olam-source/speedx-Shh/ESP-NOW prop/docs/wiring-guide.html

# SpeedX Wearable — Wiring & Assembly Guide

Per-athlete armband node · LOLIN D32 (ESP32) · 3.3 V logic · generated from the firmware in include/athlete_sensors.h

Heart-rate sensor: the firmware drives a MAX30102 optical PPG module at I²C address 0x57 (SparkFun MAX3010x library, IR LED for beat detection). The common purple GY-MAX30102 / SparkFun breakouts all work. Mount the optical window flat against the skin and keep the strap snug — contact quality matters more than any firmware tweak.

## 1. Quick facts

Item | Value
Compute board | LOLIN D32 (ESP32, onboard LiPo charger + battery sense)
Logic level | 3.3 V — never feed 5 V into an ESP32 GPIO
I²C bus | shared by HR + IMU; SDA GPIO21, SCL GPIO22, ~100 kHz
GPS link | UART2, 9600 baud (NEO-6M/M8N default)
Common ground | Mandatory — every module's GND ties to the ESP32 GND

## 2. Power & safety

- Battery: a single 18650 or 1S LiPo plugs into the LOLIN D32's JST battery connector. The board charges it over USB and regulates 3.3 V for everything else. Observe polarity — reversed LiPo can vent or catch fire.
- Sensor power: run MAX30102, MPU-6050, and the GPS from the board's 3V3 pin and GND. The NEO-6M also accepts 5 V (use the board VBUS/5V/USB pin) if its module needs it — check your breakout's silkscreen; many NEO-6M boards have an onboard regulator and prefer 3.3–5 V.
- Battery sense: the LOLIN D32 already wires the cell to GPIO35 through an onboard 100k/100k divider (BATTERY_DIVIDER 2.0). No external parts. On a plain ESP32 DevKit you must add that divider yourself.
- Current: the GPS draws the most (~25–35 mA with the antenna searching). The ESP32's 3.3 V regulator handles it, but don't also hang high-draw loads off the same rail.

## 3. Master pinout

ESP32 pin | Connects to | Signal | Notes
GPIO21 | MAX30102 SDA · MPU-6050 SDA | I²C SDA | shared bus
GPIO22 | MAX30102 SCL · MPU-6050 SCL | I²C SCL | shared bus
GPIO16 (RX2) | GPS TX | UART2 RX | data in from GPS
GPIO17 (TX2) | GPS RX | UART2 TX | RX↔TX cross over
GPIO35 | battery divider (onboard) | ADC battery | LOLIN D32 only
3V3 | VCC of HR, IMU (and GPS if 3.3 V) | power | regulated 3.3 V
5V / VBUS | GPS VCC (if it needs 5 V) | power | USB-derived
GND | GND of every module | ground | common return

## 4. Connection diagram

## 5. Module-by-module

### MAX30102 — optical heart rate (I²C 0x57)

Module | ESP32
SDA | GPIO21
SCL | GPIO22
VCC / VIN | 3V3
GND | GND

Mount the optical window against the skin (the enclosure's sensor cut-out). Shield it from ambient light; a snug strap improves the signal far more than firmware tuning.

### MPU-6050 — 6-axis IMU (I²C 0x68)

Module | ESP32
SDA | GPIO21
SCL | GPIO22
VCC | 3V3
GND | GND

Shares the I²C bus with the HR sensor — wire both SDA together and both SCL together. The addresses (0x57 vs 0x68) don't collide. Orient the board flat/consistent so cadence detection is stable.

### NEO-6M — GPS (UART2, 9600 baud)

GPS pin | ESP32 | Note
TX | GPIO16 (RX2) | cross: GPS TX → ESP RX
RX | GPIO17 (TX2) | cross: GPS RX ← ESP TX
VCC | 3V3 or 5V | per your module's regulator
GND | GND

RX/TX always cross. The ceramic patch antenna must face the sky (out the lid window), not the arm. First fix outdoors can take 30–90 s.

### Battery

Plug the 18650/LiPo into the LOLIN D32 JST connector (mind polarity). Charging and 3.3 V regulation are automatic over USB. Voltage is sensed on GPIO35 through the onboard divider.

## 6. Assembly order

1. Bench-test first. Flash the simulated build (pio run -e athlete1 -t upload) on a bare board — confirm it joins the mesh before adding sensors.
2. Solder the I²C pair (HR + IMU): SDA→21, SCL→22, both VCC→3V3, both GND→GND.
3. Power on, open the serial monitor. The firmware logs MAX30102 optical HR ready and the IMU init. If a device is missing, recheck SDA/SCL and 3.3 V.
4. Wire the GPS (remember RX↔TX cross). Take it outside; watch for a fix in the logs.
5. Plug in the battery last. Verify the battery % reads sanely on the dashboard.
6. Fit everything into the printed enclosure (speedx_armband.scad): HR window to skin, GPS antenna to the lid window, screw the lid.

## 7. Flash quick-reference

Goal | Command
Bench test (no sensors) | pio run -e athlete1 -t upload
Real hardware wearable | pio run -e athlete1_hw -t upload
Coach hub (USB to laptop) | pio run -e coach_hub -t upload
Serial monitor | pio device monitor -b 115200

Give each athlete a unique ATHLETE_NODE_ID (any hex 1–FFFD; FFFE/FFFF reserved) by copying the [env:athlete1_hw] block in platformio.ini.

## 8. Troubleshooting

Symptom | Likely cause | Fix
No HR / sensor not found | swapped SDA/SCL, no 3.3 V, dead/clone module | confirm a MAX30102 (0x57) on the bus; re-check I²C wiring & power
HR reads but noisy | loose strap, ambient light, hard effort | tighten strap; shroud the window
No GPS fix | RX/TX not crossed, antenna facing arm, indoors | swap 16/17; antenna to sky; go outside
IMU dead | address clash / bad solder | verify 0x68 on the bus; reflow joints
Battery % wrong | not a LOLIN D32 (no onboard divider) | add 100k/100k divider to an ADC pin; set -DPIN_BATTERY_ADC
Won't join mesh | different ESP-NOW channel/key | all nodes share channel + ESPNOW_ENCRYPT key

SpeedX wearable wiring guide · pins/addresses sourced from include/athlete_sensors.h. Print: File → Print (or ⌘P) → Save as PDF. Verify against your exact breakout's silkscreen before powering on.
