olam-source/speedx-Shh/ESP-NOW prop/src/athlete_wearable/main.cpp

#include <Arduino.h>
#include <WiFi.h>
#include <esp_now.h>
#include <Preferences.h>
#include "espnow_config.h"
#include "espnow_utils.h"
#include "peer_manager.h"
#include "athlete_sensors.h"
#include "ota_portal.h"

// Build-flag values are only the *defaults*. The live athlete id/team are stored
// in NVS and can be set over USB (`id <n>` / `team <n>`), so one identical binary
// flashes to every wearable — no per-athlete compile needed.
#ifndef ATHLETE_NODE_ID
#define ATHLETE_NODE_ID 11
#endif

#ifndef ATHLETE_TEAM_ID
#define ATHLETE_TEAM_ID 1
#endif

PeerManager peer_manager;
AthleteSensors sensors;          // simulated, or real hardware with -DUSE_REAL_SENSORS
Preferences prefs;               // NVS store for the runtime athlete id/team
GossipCache gossip_cache;
uint8_t sequence_number = 0;
uint16_t sample_id = 0;
uint32_t last_metric_time = 0;
uint32_t last_discovery_time = 0;
uint32_t last_peer_check = 0;
uint8_t last_peer_count = 0;

// Live identity, loaded from NVS at boot (falls back to the build-flag defaults).
node_id_t g_athlete_id = ATHLETE_NODE_ID;   // 16-bit; coach app shows it as hex
uint8_t g_team_id = ATHLETE_TEAM_ID;

// Session state, driven by coach commands relayed through the mesh.
bool session_paused = false;     // STOP_SESSION halts metric sampling

// OTA update mode (SoftAP firmware upload). While active the node leaves the mesh.
OtaPortal ota;
bool ota_mode = false;

// USB provisioning console.
String serial_line;


void onDataSent(const uint8_t* mac_addr, esp_now_send_status_t status) {
    if (status != ESP_NOW_SEND_SUCCESS) {
        Serial.printf("{\"t\":\"tx\",\"to\":\"%s\",\"ok\":false}\n",
                      ESPNowUtils::macToString(mac_addr).c_str());
    }
}

AthleteMetricsPayload readAthleteMetrics() {
    AthleteMetricsPayload metrics{};
    metrics.athlete_id = g_athlete_id;
    metrics.team_id = g_team_id;
    metrics.sample_id = sample_id++;
    metrics.uptime_ms = millis();

    // The sensor layer fills HR, pace, splits, distance, cadence, battery, etc.
    // (real hardware with -DUSE_REAL_SENSORS, otherwise simulated values).
    sensors.fillMetrics(metrics);
    return metrics;
}

void sendDiscoveryPing() {
    ESPNowMessage ping = ESPNowUtils::createPingMessage(g_athlete_id, COACH_HUB_NODE_ID, sequence_number++);
    ping.flags |= ESPNOW_FLAG_GOSSIP;
    ESPNowUtils::broadcastMessage(ping);
    Serial.println("Discovery ping broadcast for coach hub");
}

bool gossipMessage(ESPNowMessage msg) {
    if (msg.ttl == 0) {
        return false;
    }

    msg.ttl--;
    msg.hop_count++;
    msg.flags |= ESPNOW_FLAG_GOSSIP;

    PeerInfo* hub = peer_manager.getPeerById(COACH_HUB_NODE_ID);
    if (hub) {
        return ESPNowUtils::sendMessage(hub->mac, msg);
    }

    uint8_t active_count = peer_manager.getActivePeerCount();
    if (active_count == 0) {
        return ESPNowUtils::broadcastMessage(msg);
    }

    bool sent = false;
    uint8_t attempts = min<uint8_t>(GOSSIP_FANOUT, active_count);
    uint8_t start = random(0, active_count);
    for (uint8_t i = 0; i < attempts; i++) {
        PeerInfo* peer = peer_manager.getActivePeerByIndex((start + i) % active_count);
        if (peer && peer->peer_id != msg.sender_id) {
            sent |= ESPNowUtils::sendMessage(peer->mac, msg);
        }
    }

    if (!sent) {
        sent = ESPNowUtils::broadcastMessage(msg);
    }
    return sent;
}

void sendOwnMetrics() {
    AthleteMetricsPayload metrics = readAthleteMetrics();
    ESPNowMessage msg = ESPNowUtils::createAthleteMetricsMessage(g_athlete_id, sequence_number++, metrics);
    gossip_cache.remember(msg);
    bool queued = gossipMessage(msg);

    Serial.printf("Metric sample %u HR=%u pace=%u split=%u dist=%um gossip=%s\n",
                  metrics.sample_id,
                  metrics.heart_rate_bpm,
                  metrics.pace_sec_per_mile,
                  metrics.current_split_sec,
                  metrics.distance_m,
                  queued ? "queued" : "failed");
}

void handleAthleteMetrics(const uint8_t* mac, const ESPNowMessage& msg) {
    AthleteMetricsPayload metrics{};
    if (!ESPNowUtils::readAthleteMetrics(msg, metrics)) {
        Serial.println("Bad athlete metrics payload");
        return;
    }

    metrics.signal_percent = ESPNowUtils::rssiToPercentage(static_cast<int8_t>(msg.rssi));
    Serial.printf("Gossip RX athlete=%u sample=%u HR=%u pace=%u hops=%u ttl=%u\n",
                  metrics.athlete_id,
                  metrics.sample_id,
                  metrics.heart_rate_bpm,
                  metrics.pace_sec_per_mile,
                  msg.hop_count,
                  msg.ttl);

    if (msg.flags & ESPNOW_FLAG_ACK_REQUESTED) {
        ESPNowMessage ack = ESPNowUtils::createAckMessage(g_athlete_id, msg.sender_id, msg.sequence);
        ESPNowUtils::sendMessage(mac, ack);
    }

    // De-dup cache already prevents loops; forward every unique frame so no
    // athlete's metrics are dropped at relay nodes in multi-athlete sessions.
    gossipMessage(msg);
}

void handleCoachCommand(const ESPNowMessage& msg) {
    CoachCommandPayload cmd{};
    if (!ESPNowUtils::readCoachCommand(msg, cmd)) {
        return;
    }

    bool for_me = cmd.target_athlete == COACH_TARGET_ALL || cmd.target_athlete == g_athlete_id;
    if (for_me) {
        switch (static_cast<CoachCommand>(cmd.command)) {
            case CoachCommand::START_SESSION:
                sensors.onSessionStart();
                session_paused = false;
                Serial.println("Coach: START session");
                break;
            case CoachCommand::STOP_SESSION:
                session_paused = true;
                Serial.println("Coach: STOP session");
                break;
            case CoachCommand::MARK_LAP:
                sensors.markLap();
                Serial.printf("Coach: MARK lap %u\n", cmd.param);
                break;
            case CoachCommand::RESET_BEST:
                sensors.resetBest();
                Serial.println("Coach: RESET best split");
                break;
            case CoachCommand::IDENTIFY:
                Serial.printf("Coach: IDENTIFY athlete %u\n", g_athlete_id);
                break;
            default:
                break;
        }
    }

    // Keep flooding the command outward so every wearable in the mesh gets it.
    gossipMessage(msg);
}

void handleIncomingMessage(const uint8_t* mac, const ESPNowMessage& msg) {
    ESPNowUtils::ensurePeer(mac);
    peer_manager.registerPeer(mac, msg.sender_id);
    peer_manager.updatePeerActivity(mac, static_cast<int8_t>(msg.rssi), msg.sequence);

    if (msg.sender_id == g_athlete_id || gossip_cache.contains(msg)) return;
    gossip_cache.remember(msg);

    switch (msg.type) {
        case MessageType::ATHLETE_METRICS:
            handleAthleteMetrics(mac, msg);
            break;
        case MessageType::COACH_COMMAND:
            handleCoachCommand(msg);
            break;
        case MessageType::PONG:
        case MessageType::ACK:
            Serial.printf("Hub/peer response from Node %u for seq %u\n", msg.sender_id, msg.sequence);
            break;
        case MessageType::MESH_BEACON:
        case MessageType::PING:
            break;
        default:
            if (msg.flags & ESPNOW_FLAG_GOSSIP) {
                gossipMessage(msg);
            }
            break;
    }
}

#if defined(ESP_ARDUINO_VERSION_MAJOR) && ESP_ARDUINO_VERSION_MAJOR >= 3
void onDataReceived(const esp_now_recv_info_t* recv_info, const uint8_t* data, int data_len) {
    const uint8_t* mac = recv_info->src_addr;
#else
void onDataReceived(const uint8_t* mac, const uint8_t* data, int data_len) {
#endif
    ESPNowMessage msg{};
    if (!ESPNowUtils::parseMessage(data, data_len, msg)) {
        Serial.printf("Invalid frame: %d bytes\n", data_len);
        return;
    }

    handleIncomingMessage(mac, msg);
}

// ===== USB provisioning console =================================================
// Lets you assign each wearable's identity at runtime, so one binary serves all:
//   id <hex 1-FFFD>   set this athlete's node id (saved to NVS, then reboots)
//   team <0-255> set this athlete's team
//   info         print current id/team/MAC
//   reset-id     clear stored id/team (revert to build-flag defaults)
void applyAndRestart(const char* what) {
    prefs.end();
    Serial.printf("Saved %s. Restarting...\n", what);
    delay(200);
    ESP.restart();
}

bool parseUnsignedArg(const String& text, uint8_t base, uint32_t minValue, uint32_t maxValue, uint32_t& out) {
    if (text.length() == 0) {
        return false;
    }
    char* end = nullptr;
    unsigned long value = strtoul(text.c_str(), &end, base);
    if (end == text.c_str() || *end != '\0') {
        return false;
    }
    if (value < minValue || value > maxValue) {
        return false;
    }
    out = static_cast<uint32_t>(value);
    return true;
}

void handleSerialCommand(String line) {
    line.trim();
    if (line.length() == 0) return;

    int sp = line.indexOf(' ');
    String verb = (sp < 0) ? line : line.substring(0, sp);
    String arg = (sp < 0) ? String("") : line.substring(sp + 1);
    verb.toLowerCase();
    arg.trim();

    if (verb == "id") {
        // IDs are hex (e.g. "1a2b" or "0x1A2B"). base 16 accepts an optional 0x.
        uint32_t v = 0;
        if (!parseUnsignedArg(arg, 16, 1, NODE_ID_MAX, v)) {
            Serial.println("id must be hex 1-FFFD (FFFE=hub, FFFF=broadcast are reserved)");
            return;
        }
        prefs.putUShort("nid", static_cast<node_id_t>(v));
        applyAndRestart("athlete id");
    } else if (verb == "team") {
        uint32_t v = 0;
        if (!parseUnsignedArg(arg, 10, 0, 255, v)) {
            Serial.println("team must be 0-255");
            return;
        }
        prefs.putUChar("team", static_cast<uint8_t>(v));
        applyAndRestart("team");
    } else if (verb == "info") {
        uint8_t mac[6];
        ESPNowUtils::getDeviceMac(mac);
        Serial.printf("id=0x%04X (%u) team=%u mac=%s uptime=%lus\n",
                      g_athlete_id, g_athlete_id, g_team_id,
                      ESPNowUtils::macToString(mac).c_str(),
                      static_cast<unsigned long>(millis() / 1000));
    } else if (verb == "reset-id") {
        prefs.remove("nid");
        prefs.remove("team");
        applyAndRestart("defaults");
    } else if (verb == "ota") {
        ota.begin(String("SpeedX-OTA-") + g_athlete_id);
        ota_mode = true;
#if defined(USE_BLE_HR)
    } else if (verb == "ble") {
        Serial.println(sensors.bleStatus());
#endif
    } else if (verb == "help") {
        Serial.println("commands: id <hex 1-FFFD> | team <0-255> | info | ota | reset-id"
#if defined(USE_BLE_HR)
                       " | ble"
#endif
                       " | help");
    } else {
        Serial.printf("unknown command '%s' (try help)\n", verb.c_str());
    }
}

void pollSerialConsole() {
    while (Serial.available() > 0) {
        char c = static_cast<char>(Serial.read());
        if (c == '\n' || c == '\r') {
            if (serial_line.length() > 0) {
                handleSerialCommand(serial_line);
                serial_line = "";
            }
        } else if (serial_line.length() < 48) {
            serial_line += c;
        }
    }
}

void setupWiFi() {
    if (!ESPNowUtils::initWiFi("Athlete_Wearable")) {
        while (true) delay(1000);
    }

    uint8_t mac[6];
    ESPNowUtils::getDeviceMac(mac);
    Serial.print("Wearable MAC: ");
    Serial.println(ESPNowUtils::macToString(mac));
}

void setupESPNow() {
    if (!ESPNowUtils::initESPNow()) {
        while (true) delay(1000);
    }

    esp_now_register_send_cb(onDataSent);
    esp_now_register_recv_cb(onDataReceived);
    ESPNowUtils::addBroadcastPeer();
}

void setup() {
    Serial.begin(115200);
    delay(1000);

    // Load the runtime identity (NVS), falling back to the build-flag defaults.
    prefs.begin("speedx", false);
    g_athlete_id = prefs.getUShort("nid", ATHLETE_NODE_ID);   // 16-bit id (key "nid")
    g_team_id = prefs.getUChar("team", ATHLETE_TEAM_ID);
    randomSeed(static_cast<uint32_t>(micros()) ^ g_athlete_id);

    Serial.println("\n\n=== Athlete Wearable Gossip Node ===");
    Serial.printf("{\"t\":\"boot\",\"role\":\"wearable\",\"node\":%u,\"team\":%u,\"fw\":\"%s\"}\n",
                  g_athlete_id, g_team_id, SPEEDX_FW_VERSION);
    Serial.printf("Coach Hub: 0x%04X | Channel: %u\n", COACH_HUB_NODE_ID, ESPNOW_CHANNEL);
    Serial.println("USB console: id <hex 1-FFFD> | team <0-255> | info | ota | reset-id | help");

    setupWiFi();
    setupESPNow();

    if (!sensors.begin()) {
        Serial.println("Sensor init incomplete - continuing with available data");
    }

#if defined(USE_BLE_HR)
    sensors.beginBle();
    Serial.println(sensors.bleStatus());
    Serial.println("  Pair once in Garmin/Coros/Apple Watch sensor settings (device name: SpeedX)");
#endif

    sendDiscoveryPing();
    last_discovery_time = millis();
}

void loop() {
    uint32_t now = millis();

    pollSerialConsole();   // accept id/team provisioning over USB

    if (ota_mode) {        // OTA portal owns the radio; mesh is suspended until reboot
        ota.handle();
        delay(2);
        return;
    }

    sensors.update();      // keep streaming sensors (HR beats, GPS bytes, IMU) fresh

    if (!session_paused && now - last_metric_time >= ATHLETE_METRIC_INTERVAL_MS) {
        sendOwnMetrics();
        last_metric_time = now;
    }

    if (now - last_discovery_time >= ESPNOW_DISCOVERY_INTERVAL_MS) {
        sendDiscoveryPing();
        last_discovery_time = now;
    }

    if (now - last_peer_check >= 5000) {
        peer_manager.checkPeerTimeout(ESPNOW_DEFAULT_PEER_TIMEOUT_MS);
        uint8_t peers = peer_manager.getActivePeerCount();
        if (peers != last_peer_count) {
            Serial.printf("{\"t\":\"peers\",\"count\":%u}\n", peers);
            last_peer_count = peers;
        }
        last_peer_check = now;
    }

    delay(5);   // tight loop keeps HR beat-detection and GPS UART reads responsive
}
