olam-source/speedx-Shh/(commit log)

2026-06-18 Add ESP-NOW multi-node framework and examples
    Introduce a complete ESP-NOW workspace: PlatformIO project files, VS Code configs, README, and a .gitignore. Adds core headers (espnow_config.h, espnow_utils.h, peer_manager.h) providing message structures, utilities and peer management, plus three example nodes (sender, receiver, mesh) under src/. Includes platformio.ini with three envs and VSCode tasks/launch/extension recommendations. Note: update receiver MAC and serial ports in platformio.ini/source before flashing.
2026-06-18 Add athlete wearable mesh + coach hub and live dashboard
    Completes the SpeedX router-free athlete-tracking system on top of the
    ESP-NOW framework:
    - coach_hub: central USB ESP-NOW adapter (mesh sink) that collects every
    athlete's metrics, streams them to the host as line-delimited JSON,
    beacons for discovery, ACKs frames, and relays coach commands.
    - athlete_wearable: now honors coach commands (start/stop/mark-lap/
    reset-best/identify) relayed through the gossip mesh, with session-
    relative distance/splits.
    - espnow_config/espnow_utils: CoachCommand type + payload, command
    builder/parser, and a JSON metrics printer for the USB stream.
    - dashboard/coach_dashboard.html: zero-install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
    [espnow_config.h, espnow_utils.h, main.cpp]
2026-06-18 Add real sensor support: MAX30102 HR, MPU-6050, GPS, battery
    Make the wearable read real hardware instead of only simulating:
    - include/athlete_sensors.h: AthleteSensors abstraction with two back ends
    selected at build time. Default = simulated metrics (bare ESP32, no
    sensors). -DUSE_REAL_SENSORS = MAX30102 heart rate, MPU-6050 cadence/
    dynamics, u-blox NEO-M8N/6M GPS distance/pace/splits, and battery ADC.
    - athlete_wearable: delegates metric reads to the sensor layer and pumps
    it every loop; coach commands drive session/lap/best hooks.
    - platformio.ini: athlete1_hw env with -DUSE_REAL_SENSORS and lib_deps
    (SparkFun MAX3010x, TinyGPSPlus, Adafruit MPU6050).
    - HARDWARE.md: cheap/sc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
2026-06-19 Fix invalid board id (esp32doit-devkit1 -> esp32doit-devkit-v1)
    The board id never matched a real PlatformIO board, so no environment
    could build. Corrected to the canonical DOIT ESP32 DEVKIT V1 id.
    Verified by building every environment with PlatformIO 6.1.19 +
    espressif32 7.0.1 (Arduino-ESP32 3.x): coach_hub, athlete1 (simulated),
    athlete1_hw (real MAX30102/MPU-6050/GPS libraries), and the three legacy
    demo nodes all compile and link.
2026-06-19 Add multi-page project wiki (docs/) for developers
    A Notion-style, linked knowledge base under ESP-NOW prop/docs/, written for
    developers/engineers and importable into Notion (Markdown import):
    - Home/index with page directory and at-a-glance table
    - 01 Overview, 02 Architecture (with mermaid diagrams), 03 Mesh Protocol,
    04 Firmware & Code Map, 05 Sensors & Metrics, 06 Hardware & Budget,
    07 Build/Flash/Dashboard, 08 Manufacturing & Roadmap
    Cross-linked to the source files and to HARDWARE.md; README now points to it.
2026-06-19 firmware: runtime athlete-ID provisioning (one binary for all wearables)
    Athlete id/team are now stored in NVS and set over USB at runtime, so the
    same binary flashes to every wearable instead of compiling one per athlete.
    Build-flag values become defaults only.
    - USB console: id <1-249> | team <0-255> | info | reset-id | help
    (id/team changes persist to NVS and reboot)
    - replaced compile-time ATHLETE_NODE_ID/TEAM usages with runtime globals
    - verified: athlete1 (sim) and athlete1_hw (real sensors) both build
    - docs: updated "adding athletes" + roadmap statuses
    [main.cpp]
2026-06-19 firmware: AES-256-GCM frame encryption + OTA firmware updates
    Encryption (include/espnow_crypto.h):
    - Authenticated payload encryption (AES-256-GCM via mbedtls) for every
    frame; header stays clear for relay routing but immutable fields are
    bound as GCM AAD. Foreign/forged frames fail the tag check and drop.
    - Wire payload = [12B IV][ciphertext][16B tag]; per-hop re-encryption.
    - Key = SHA-256(passphrase); set -DESPNOW_PSK_PASSPHRASE, default ON,
    disable with -DESPNOW_ENCRYPT=0. Wired into ESPNowUtils send/parse.
    OTA (include/ota_portal.h):
    - `ota` USB command starts a SoftAP + web upload page (Update.h) so a
    wearable can be reflashed wirelessly with no router.
    Verified: coach_hub,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
    [espnow_crypto.h, espnow_utils.h, main.cpp, ota_portal.h]
2026-06-19 Prune over-engineering (ponytail audit): -3 demo nodes + dead code
    - delete node_sender/receiver/mesh demos + their platformio envs and docs
    - delete dead Config struct, SensorDataPayload, printAthleteMetricsCsv,
    createDataMessage/createMeshDataMessage, PeerManager removePeer/updatePeerRssi
    - trim addPeer to (mac, channel) — ESP-NOW per-peer encrypt path unused
    - drop unused MessageType values (DATA/CONFIG/ERROR/MESH_DATA/ATHLETE_EVENT)
    - coach_hub AthleteRecord: drop write-only metrics/hops/rssi/total_samples
    - drop athlete2/3 envs (runtime `id` provisioning replaces them)
    Verified: coach_hub, athlete1, athlete1_hw all build.
    [espnow_config.h, espnow_utils.h, main.cpp, peer_manager.h]
2026-06-21 firmware: fix gossip relay dropping peer metrics in multi-athlete mesh
    The global last_gossip_time gate in handleAthleteMetrics capped relay
    throughput to one forwarded frame per 750 ms regardless of how many
    athletes were transmitting. In a 30-athlete session a relay node would
    drop ~95 % of received peer metrics. The de-dup cache already prevents
    routing loops via sequence+origin tracking, so the rate-limit was both
    incorrect and redundant. Removed the gate and the dead variable.
    [main.cpp]
2026-06-21 firmware: silence coach-command echo warnings in hub receive path
    Wearables flood COACH_COMMAND frames back through the mesh; the hub's
    isCached de-dup catches most, but any that slip through hit the default
    case and emit a spurious JSON warn line to the USB stream. The dashboard
    logs every warn — this produced noise on every command broadcast. Added
    COACH_COMMAND to the silent-discard cases.
    [main.cpp]
2026-06-21 firmware: fix checkPeerTimeout return type (bool -> void)
    The function always returned true and no caller checked the value.
    Changed to void and collapsed the double-nested if.
    [peer_manager.h]
2026-06-21 build: add NimBLE-Arduino + USE_BLE_HR flag to wearable envs
    athlete1 (sim + BLE) and athlete1_hw (full hardware + BLE) now pull
    h2zero/NimBLE-Arduino. The USE_BLE_HR flag gates the BLE HR reader in
    athlete_sensors.h so coach_hub and bare-sim builds stay unaffected.
2026-06-21 firmware: BLE HR strap support with one-time bonding (USE_BLE_HR)
    Adds BleHrReader to athlete_sensors.h. On first boot it scans for any
    BLE Heart Rate Service (0x180D) strap, bonds, and persists the MAC +
    address type in NVS. Every boot after that reconnects directly — no scan,
    no user action. On disconnect it auto-reconnects with a 5 s back-off.
    Works in parallel with Garmin / Coros watches: those receive the same
    strap's ANT+ broadcast; the ESP32 reads the simultaneous BLE broadcast.
    The athlete's existing tracking workflow is completely unaffected.
    HR from the strap overrides MAX30102 / simulated values in fillMetrics().
    Falls back to optical / simulated when the strap is out of range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
2026-06-21 firmware: wire BLE HR serial commands and setup init
    Adds two serial commands (guarded by USE_BLE_HR):
    strap — print current strap status (connected / bonded / scanning)
    strap-reset — clear stored MAC and scan for a new strap
    Calls sensors.beginBle(prefs) in setup() after sensor init so the BLE
    stack starts with the athlete's NVS identity already loaded. Prints
    strap status at boot so the coach can confirm pairing without a monitor.
    [main.cpp]
2026-06-22 build: swap MAX30102 lib for MAX30003 ECG pin defs in platformio.ini
    SpeedX is now a 1-piece integrated chest strap — no external HR strap needed.
    Remove SparkFun MAX3010x dependency; add MAX30003 SPI pin defines so the
    minimal ECG driver (written inline in athlete_sensors.h) knows which GPIO to
    use. LEDC channel 7 drives FCLK at ~32768 Hz; note in comment to replace with
    an external oscillator if BPM accuracy needs tightening.
2026-06-22 feat: replace BleHrReader+MAX30102 with BleHrServer+MAX30003 ECG
    SpeedX is now a 1-piece integrated device that IS the chest strap rather than
    reading from one. Two parallel data paths from a single HR measurement:
    1. BLE peripheral (BleHrServer) — broadcasts via standard HRS 0x180D so any
    Garmin, Coros, Apple Watch, or Wahoo auto-pairs once and reconnects forever.
    2. ESP-NOW mesh — continues sending HR + pace/GPS/IMU to the coach hub as before.
    MAX30003 replaces MAX30102:
    - Single-lead ECG with hardware RTOR detection fires an ISR on each R peak.
    - BPM = 245760 / RTOR_val (FCLK=32768 Hz, RTOR_WNDW=3 per CNFG_RTOR1=0x3FC600).
    - SPI helpers ecgWrite/ecgRead are inline in a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
    [athlete_sensors.h]
2026-06-22 feat: update wearable setup and console for BLE peripheral + ECG
    Replace strap-centric setup with the BLE server init path: no Preferences
    needed, no MAC storage, no strap-reset workflow. The pairing story is now
    "add SpeedX in your watch's sensor settings once" — handled entirely by the
    standard BLE HRS peripheral that boots on every power-on.
    Serial console changes:
    - Remove: strap, strap-reset
    - Add: ble (prints current BLE server status and client count)
    [main.cpp]
2026-06-22 build: switch from MAX30003 ECG to MAXM86161 optical HR (wristband form factor)
    Remove SPI-specific ECG pin flags (-DPIN_ECG_*). MAXM86161 is I2C — shares the
    existing SDA/SCL bus with the MPU-6050, no extra pins needed. Driver is written
    inline in athlete_sensors.h; no new library dependency.
2026-06-22 feat: swap MAX30003 ECG for MAXM86161 optical HR (wristband/armband)
    MAXM86161 is a 2.9x4.3mm ultra-compact optical sensor — designed for wrist
    wearables. Runs on shared I2C bus with the MPU-6050 (no extra pins). Green LED
    selected for slot 1; tagged FIFO format means IR/red slots can be added later
    for SpO2 without a config change.
    Beat detection uses a self-calibrating peak/valley tracker with 50% mid-point
    threshold — adapts to different skin tones and varying arm positions without
    manual calibration. Rolling 4-beat average smooths out noisy pulses.
    Two ponytail tuning knobs left in code:
    - LED1_PA 0x20 (~3.84mA) — raise to 0x40 if signal is weak on dark skin tones
    - amp < 300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
    [athlete_sensors.h]
2026-06-22 Widen node IDs to 16-bit (hex) for unlimited scaling
    Node/athlete IDs were a single byte (1..249, 250=hub, 255=broadcast),
    capping a deployment at ~249 wearables. Widen the on-wire id to a 16-bit
    node_id_t (~65k nodes; FFFE=hub, FFFF=broadcast) — effectively unlimited
    for any team or league. The width lives in one typedef (node_id_t) so it
    can move to 32-bit later if ever needed.
    - espnow_config.h: node_id_t alias; sender_id/receiver_id, athlete_id,
    target_athlete, GossipRecord.origin_id, PeerInfo.peer_id → node_id_t;
    header grows 14→16 bytes (frame still 250, static_asserts pass).
    - espnow_utils.h / peer_manager.h: id params widened.
    - espnow_crypto.h: AAD now carries both id byt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
2026-06-23 feat: GPS route telemetry, BLE footpod profile, mesh dedup hardening
    - Add raw GPS lat_e7/lon_e7 to the metrics payload + hub JSON; real
    fix in fillReal, a simulated oval track in fillSimulated. Lets the
    coach dashboard draw a route map. Docs updated to match.
    - BLE: advertise the Running Speed & Cadence service (0x1814) so a
    paired Garmin/Coros/Apple watch reads pace, cadence and distance as
    a footpod (alongside the existing 0x180D heart-rate service).
    - Mesh: bump GOSSIP_CACHE_SIZE 32 -> 128 (more de-dup memory, still
    fits uint8_t), drop the unused GOSSIP_RETRY_INTERVAL_MS constant and
    the write-only FORWARDED/URGENT flags.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
    [athlete_sensors.h, espnow_config.h, espnow_utils.h, main.cpp]
2026-06-23 Add parametric 3D-printable armband enclosure
    OpenSCAD model sized to the BOM: case body with concave arm-curve,
    integrated strap slots, MAX30102 skin window, USB-C port, GPS antenna
    shelf, screw-down lid, plus a TPU skin pad and a foot-pod variant.
    [speedx_armband.scad]
2026-06-23 hw: cheaper BOM — MAX30102 HR, NEO-6M GPS, flat LiPo; add wiring guide
    - HR sensor: revert the PPG driver from MAXM86161 to the common, cheap
    MAX30102 (I2C 0x57) via the SparkFun MAX3010x library (getIR +
    checkForBeat). Add the lib to athlete1_hw.
    - GPS: make the NEO-6M the default everywhere (1 Hz, ~$8); NEO-M8N is
    now the documented upgrade. No firmware change — same NMEA, pins, and
    9600 baud default.
    - Battery: document the flat 1S LiPo as primary; drop enclosure
    inner_height 22 -> 16 for the slimmer pack.
    - Add docs/wiring-guide.html: printable per-module wiring + assembly.
    Builds verified: athlete1_hw and athlete1 SUCCESS.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
    [speedx_armband.scad]
2026-06-23 hr: IMU-aided motion-artifact rejection for MAX30102
    Optical HR is noisy at hard effort because arm-swing corrupts the PPG.
    Use the on-board MPU-6050 to tell a heartbeat from a footfall:
    - median of an 8-beat window (robust to the odd artifact beat) replaces
    the running mean
    - physiological slew limit rejects beats implying impossible HR jumps
    - the slew limit tightens when the IMU motion envelope is high, so
    stride-induced false beats get thrown out while running
    On-device sensor fusion, no extra hardware. Builds: athlete1_hw SUCCESS.
    [athlete_sensors.h]
2026-06-27 v0.8.35: firmware versioning, dashboard revamp, quieter mesh logging
    Add SPEEDX_FW_VERSION and shared stale threshold, emit fw in boot JSON,
    revamp the browser dashboard to match the coach app aesthetic with hex IDs
    and GPS, and reduce wearable serial noise.
    [espnow_config.h, main.cpp]
